weifengdq/BLDC_DRV11873/Picture & Image/J-link.png

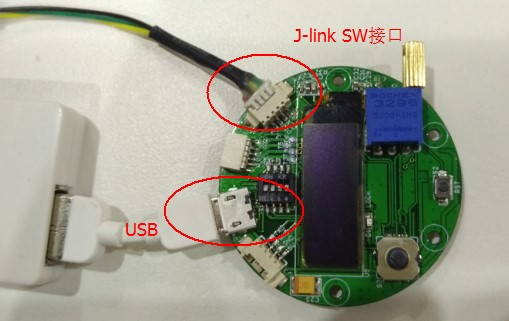
Picture & Image/J-link.png
