weifengdq/BLDC_DRV11873/Picture & Image/B0.png

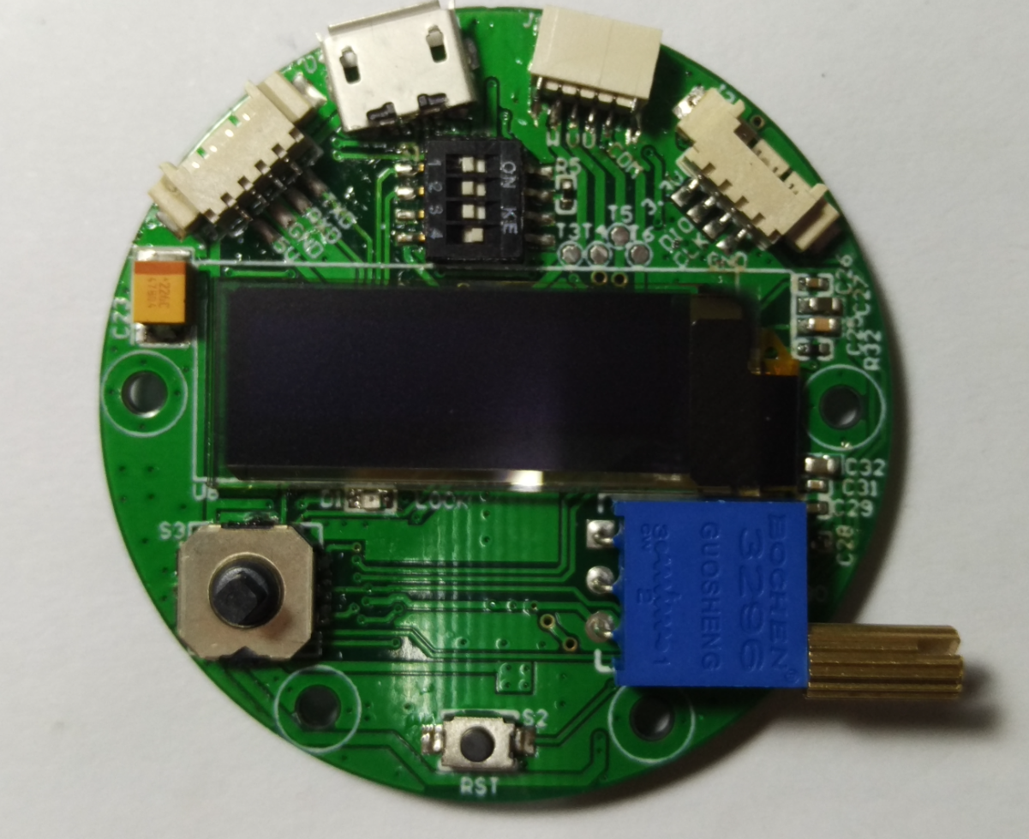
Picture & Image/B0.png
