weifengdq/BLDC_DRV11873/README.md

# BLDC_DRV11873
A BLDC Control Project With DRV11873 Driver, STM32F030F4P6 MCU, OLED, Speed and Current Detection etc.
