weifengdq/BLDC_DRV11873/Picture & Image/ADC0.png

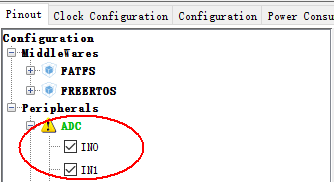
Picture & Image/ADC0.png
