weifengdq/BLDC_DRV11873/Picture & Image/ADC1.png

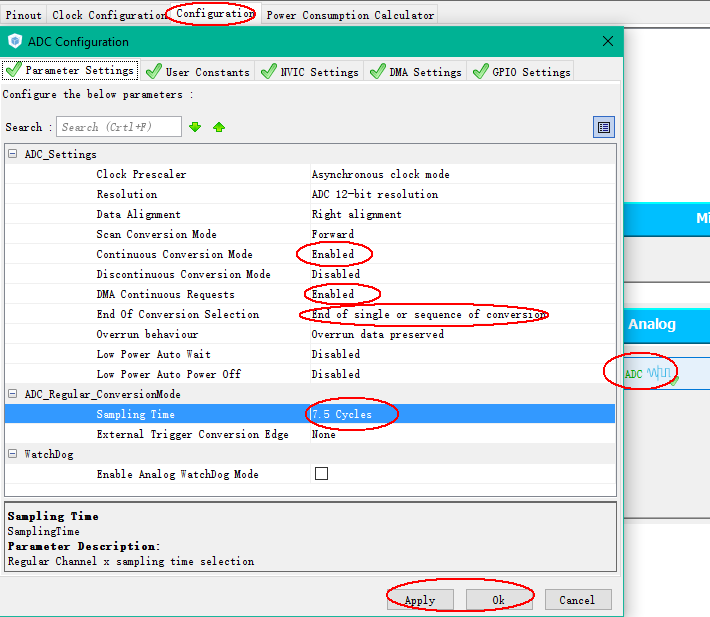
Picture & Image/ADC1.png
