weifengdq/BLDC_DRV11873/Picture & Image/ADC2.png

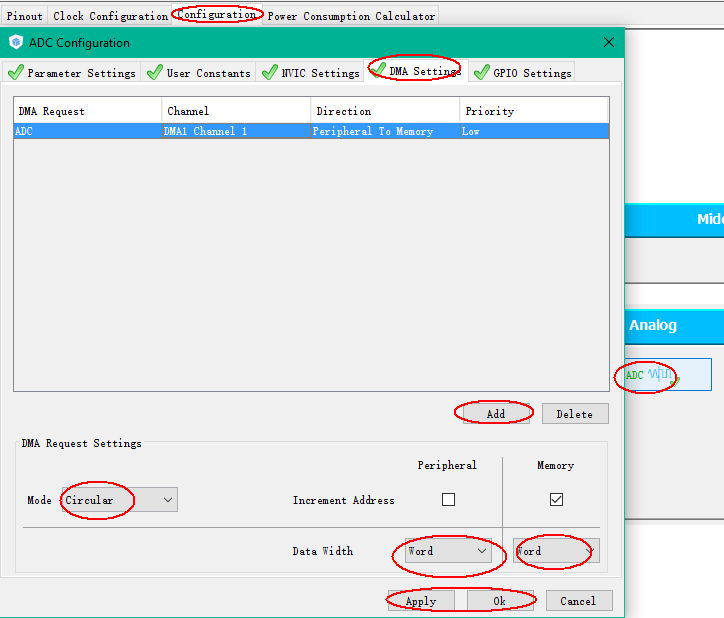
Picture & Image/ADC2.png
