weifengdq/BLDC_DRV11873/Picture & Image/B1.png

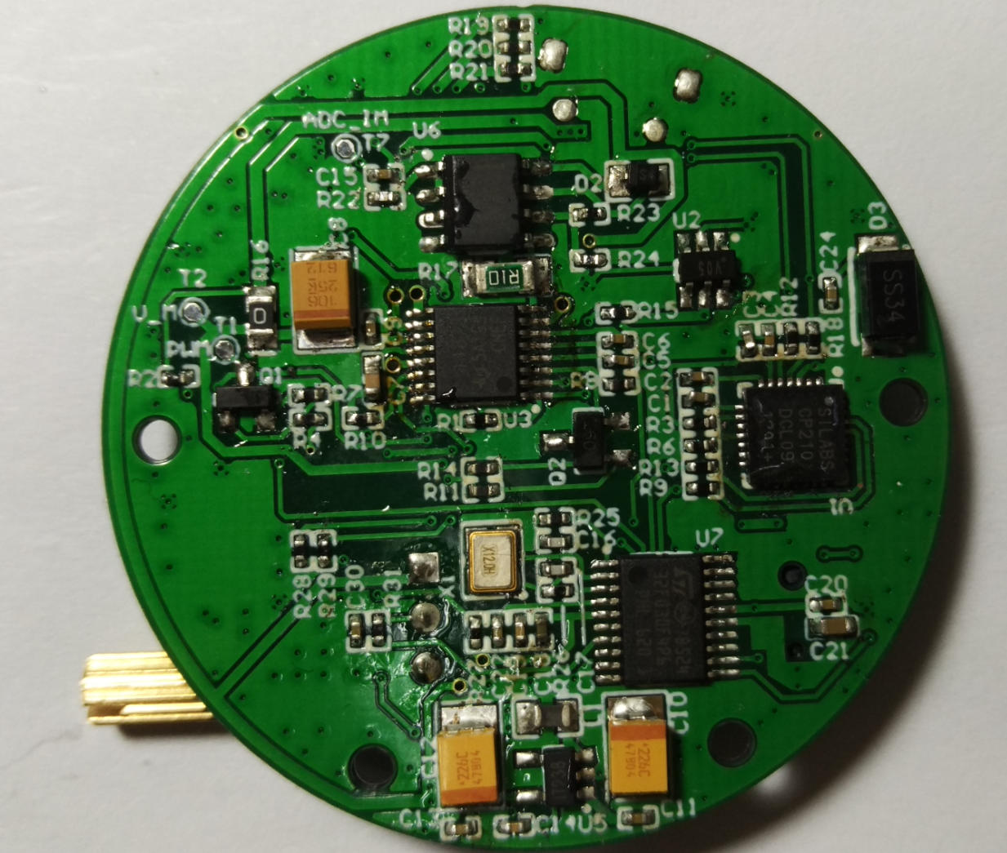
Picture & Image/B1.png
