weifengdq/BLDC_DRV11873/Picture & Image/B2.png

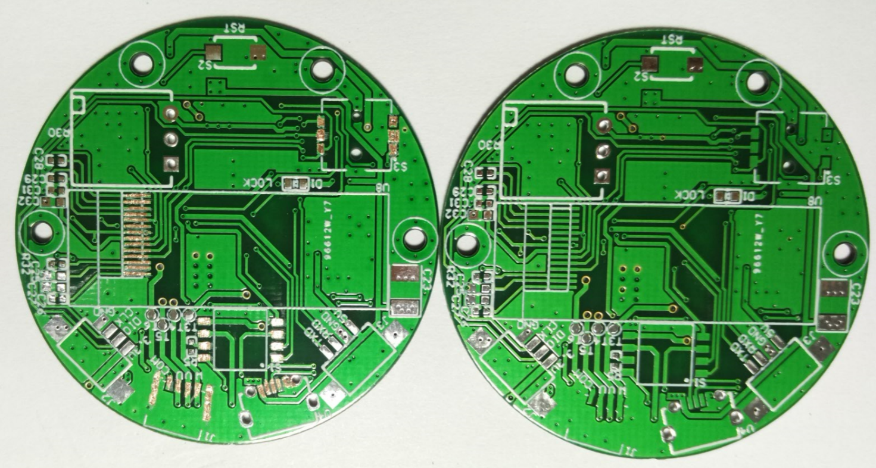
Picture & Image/B2.png
