weifengdq/BLDC_DRV11873/Picture & Image/B3.png

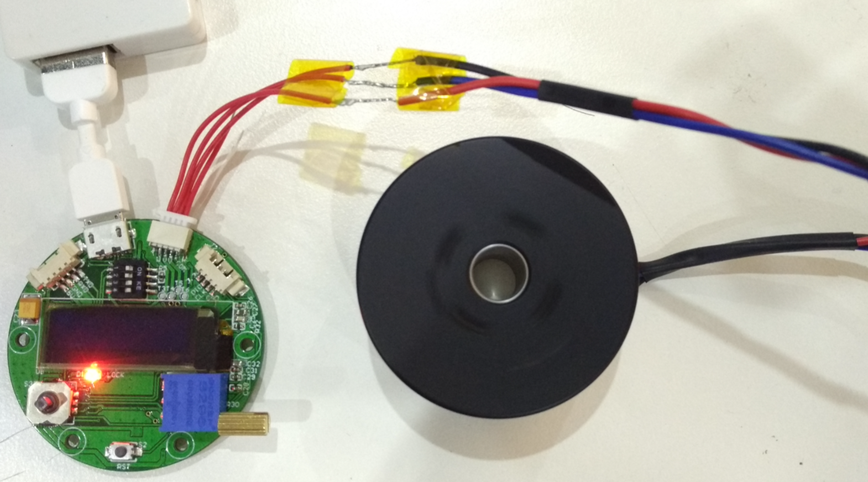
Picture & Image/B3.png
