weifengdq/BLDC_DRV11873/Picture & Image/Clock Configuration.png

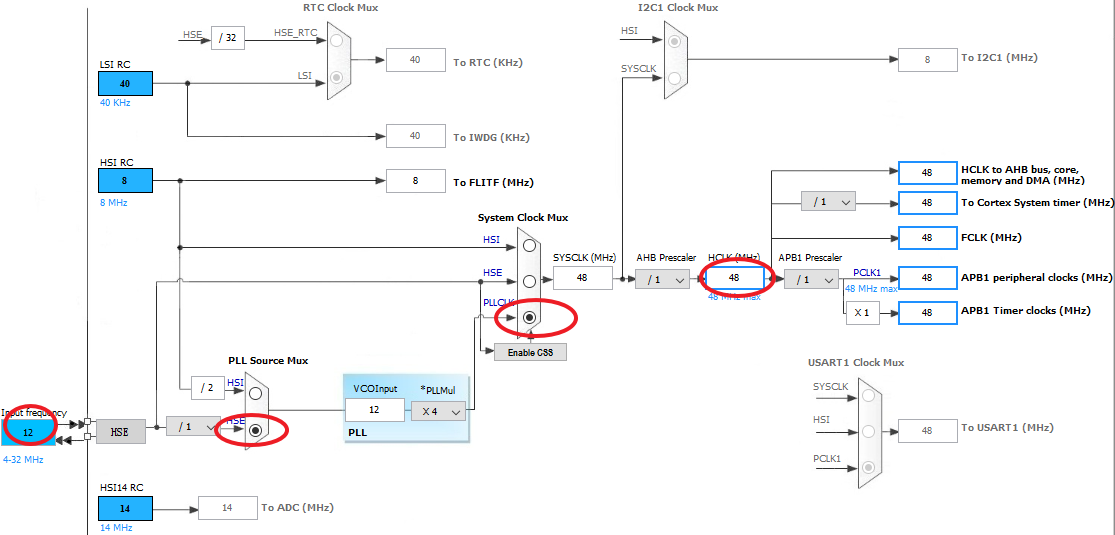
Picture & Image/Clock Configuration.png
