weifengdq/BLDC_DRV11873/Picture & Image/Code Generator.png

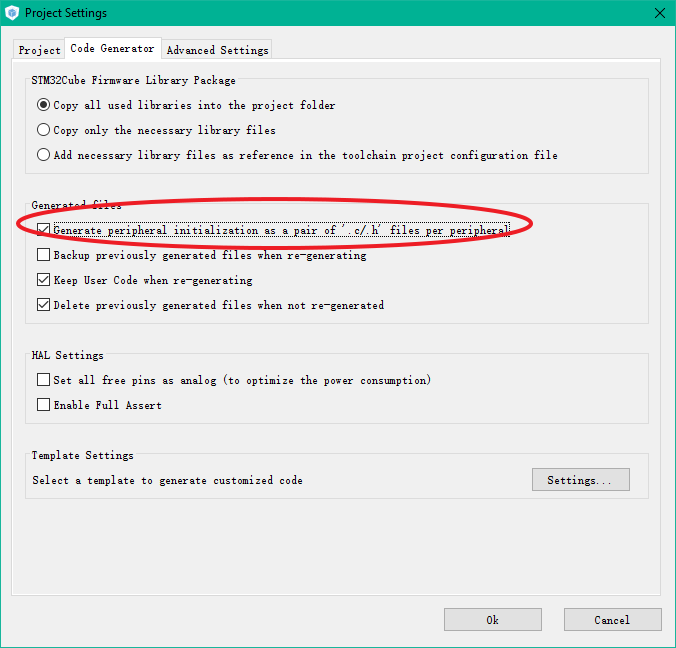
Picture & Image/Code Generator.png
