weifengdq/BLDC_DRV11873/Picture & Image/display.png

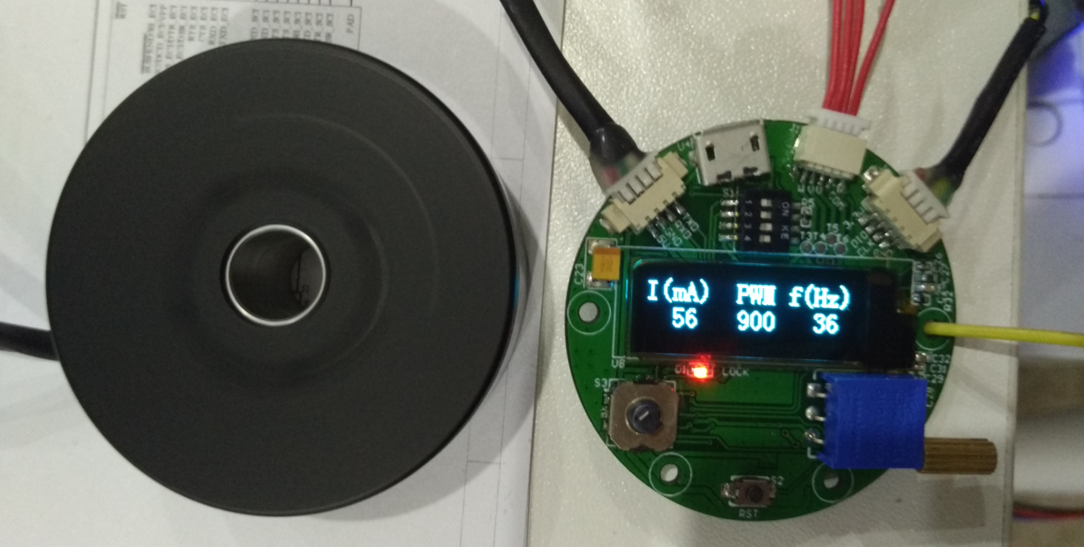
Picture & Image/display.png
