weifengdq/BLDC_DRV11873/Picture & Image/DRV11873官方评估板原理图.png

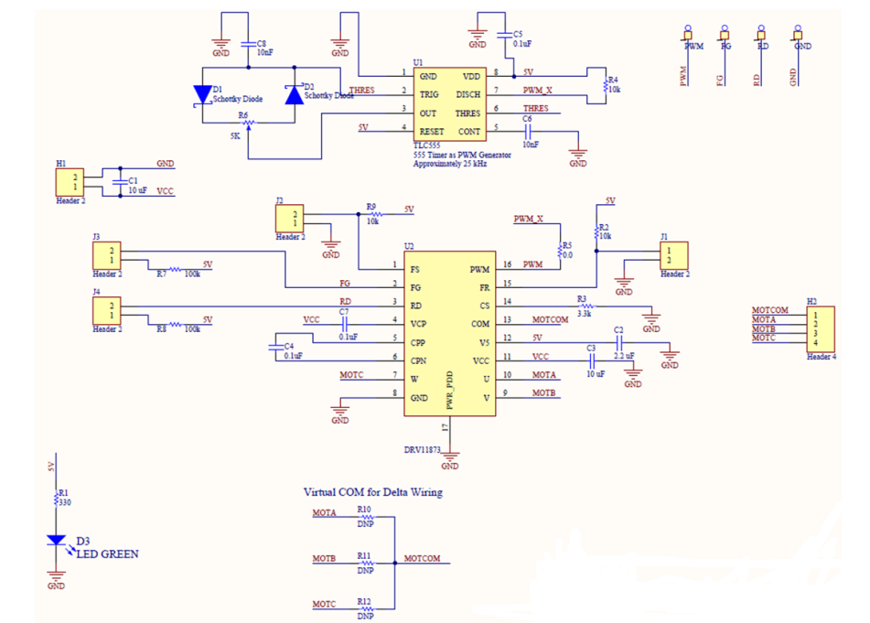
Picture & Image/DRV11873官方评估板原理图.png
