weifengdq/BLDC_DRV11873/Picture & Image/Flash.png

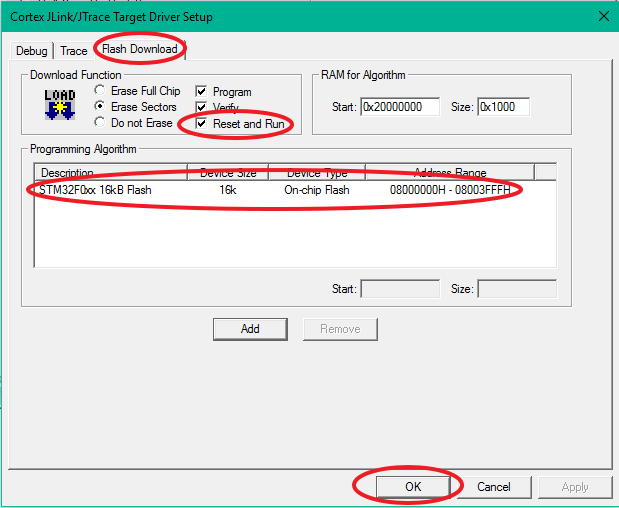
Picture & Image/Flash.png
