weifengdq/BLDC_DRV11873/Picture & Image/IIC.png

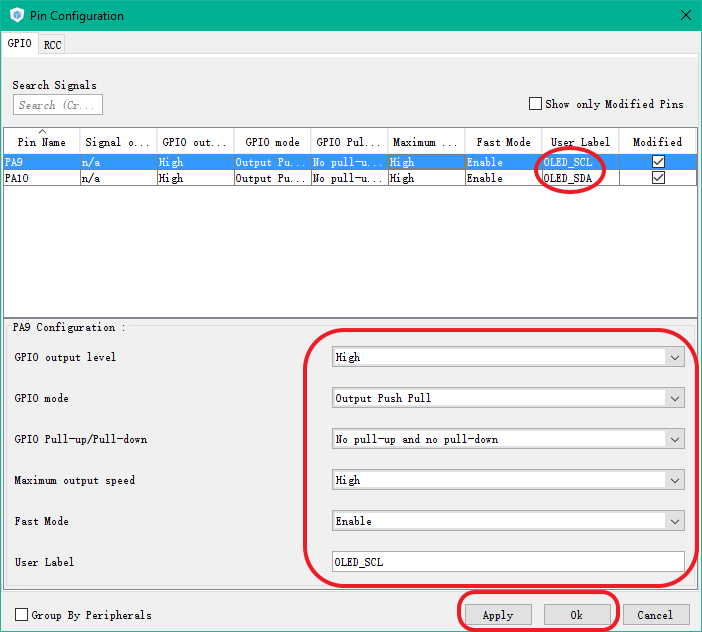
Picture & Image/IIC.png
