weifengdq/BLDC_DRV11873/Picture & Image/Project.png

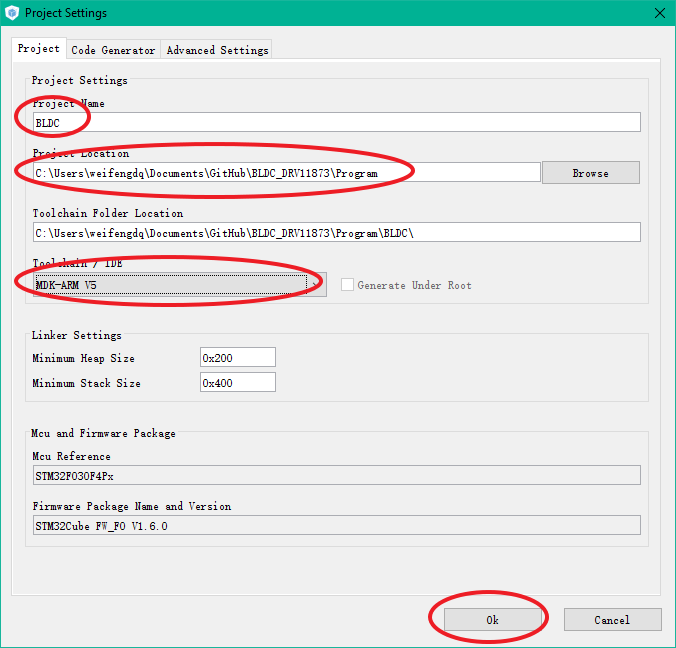
Picture & Image/Project.png
