weifengdq/BLDC_DRV11873/Picture & Image/PWM400.png

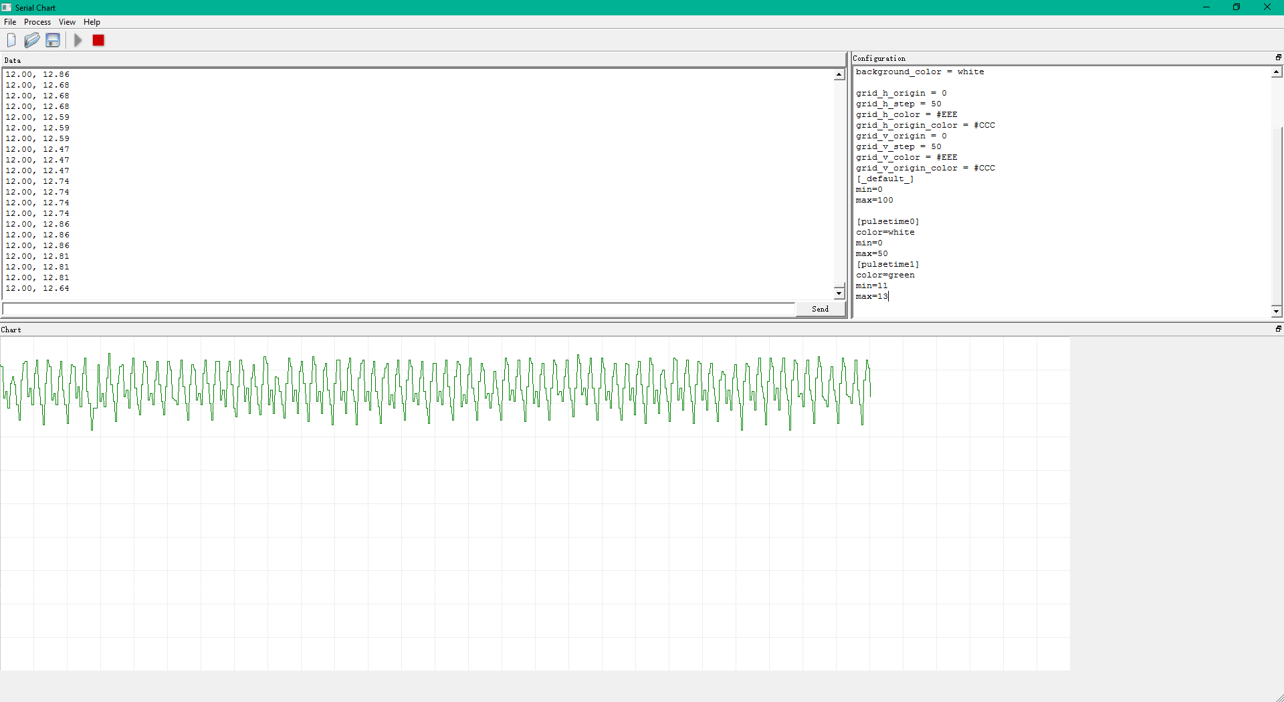
Picture & Image/PWM400.png
