weifengdq/BLDC_DRV11873/Picture & Image/PWM500.png

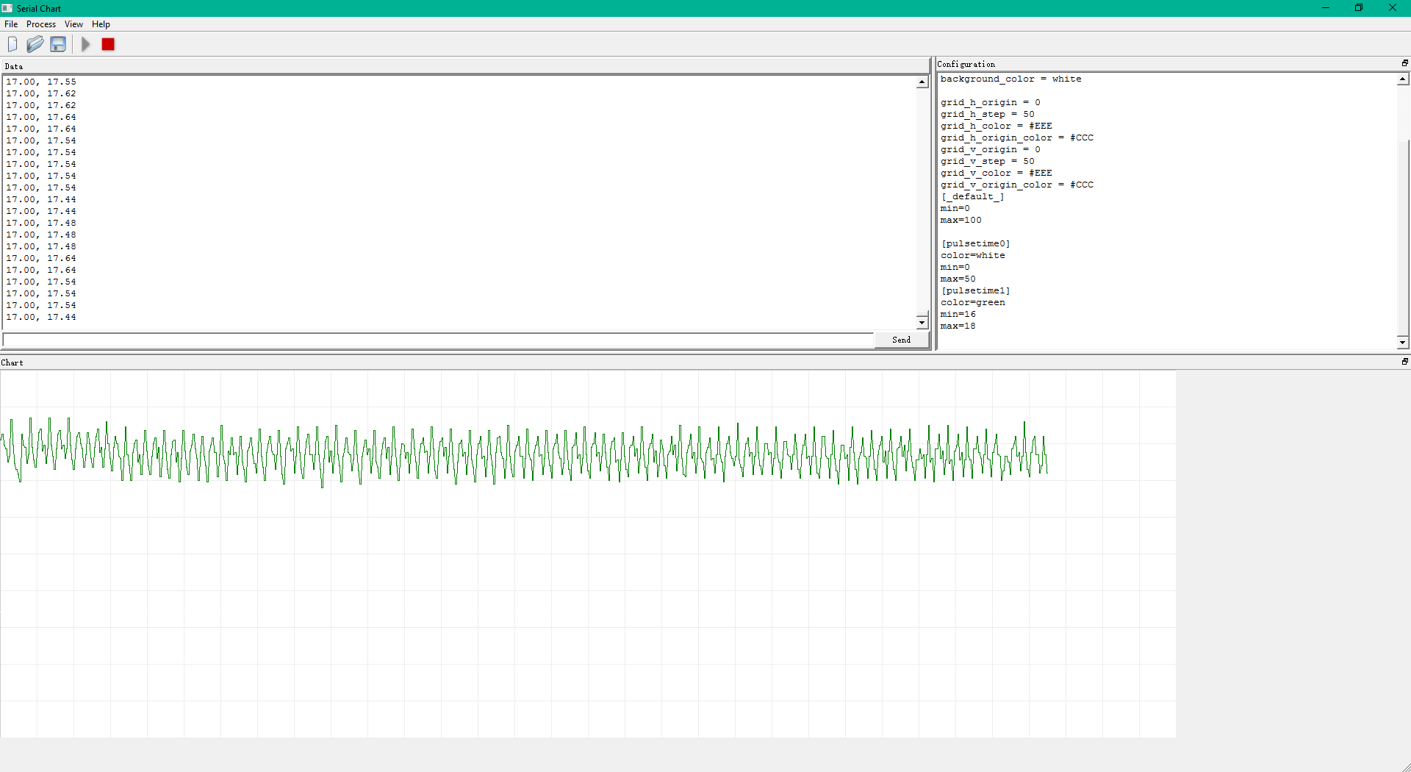
Picture & Image/PWM500.png
