weifengdq/BLDC_DRV11873/Picture & Image/PWM600.png

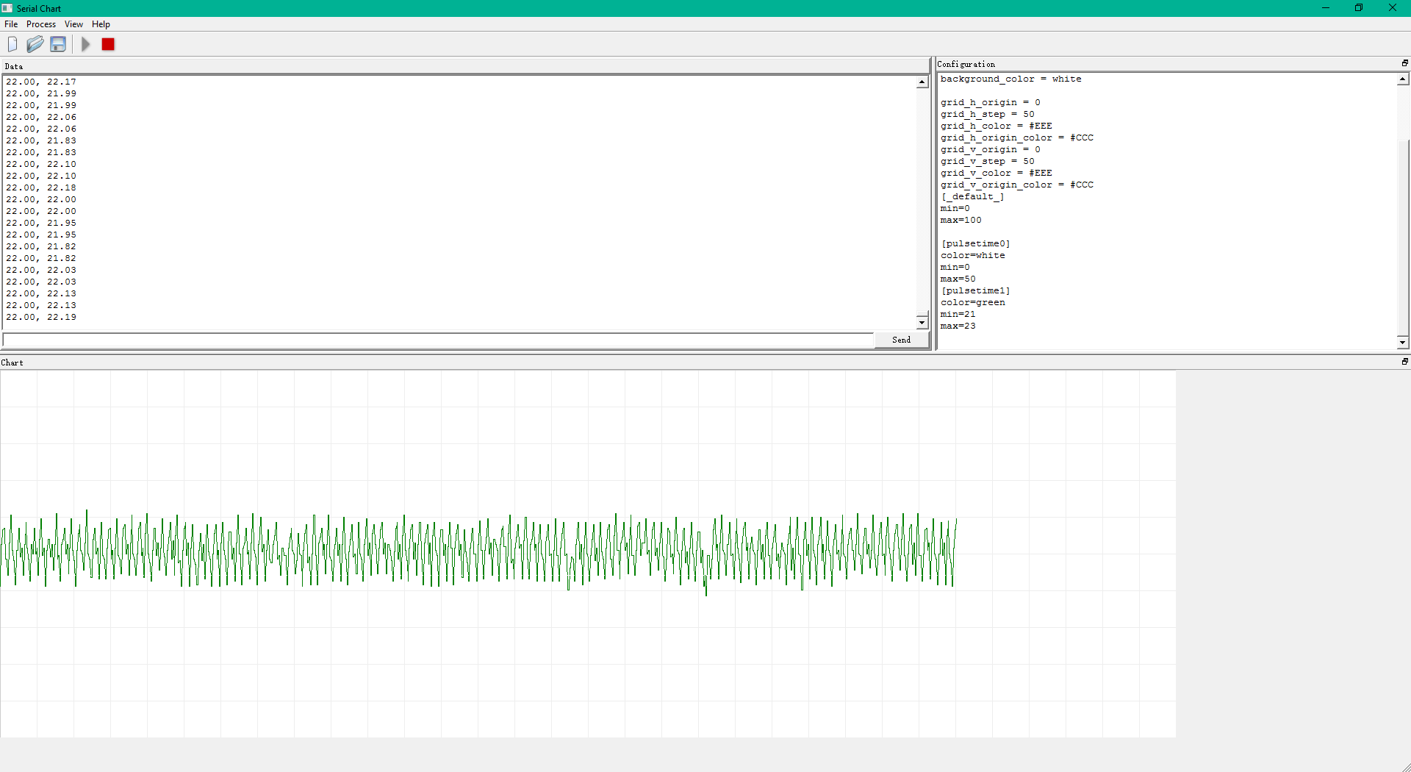
Picture & Image/PWM600.png
