weifengdq/BLDC_DRV11873/Picture & Image/PWM800.png

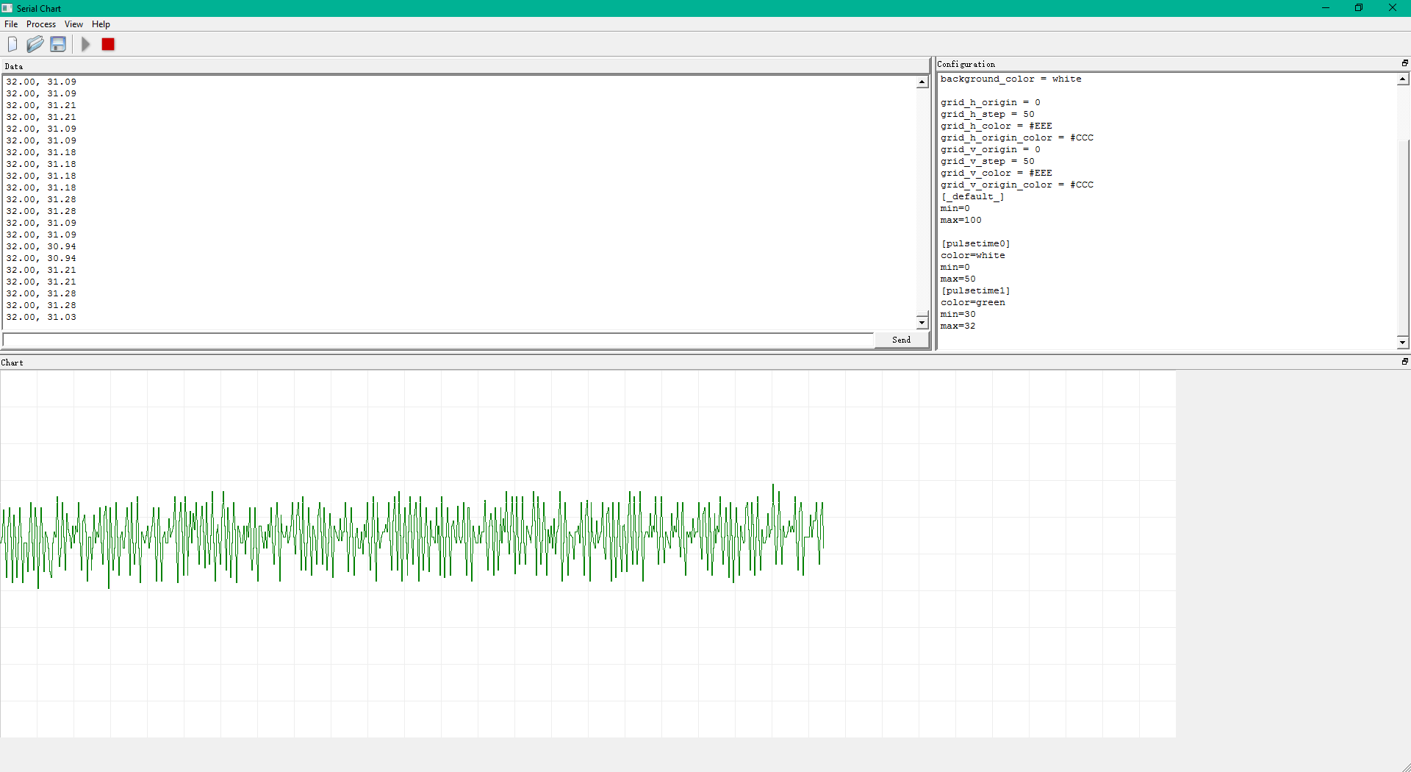
Picture & Image/PWM800.png
