weifengdq/BLDC_DRV11873/Picture & Image/PWM900.png

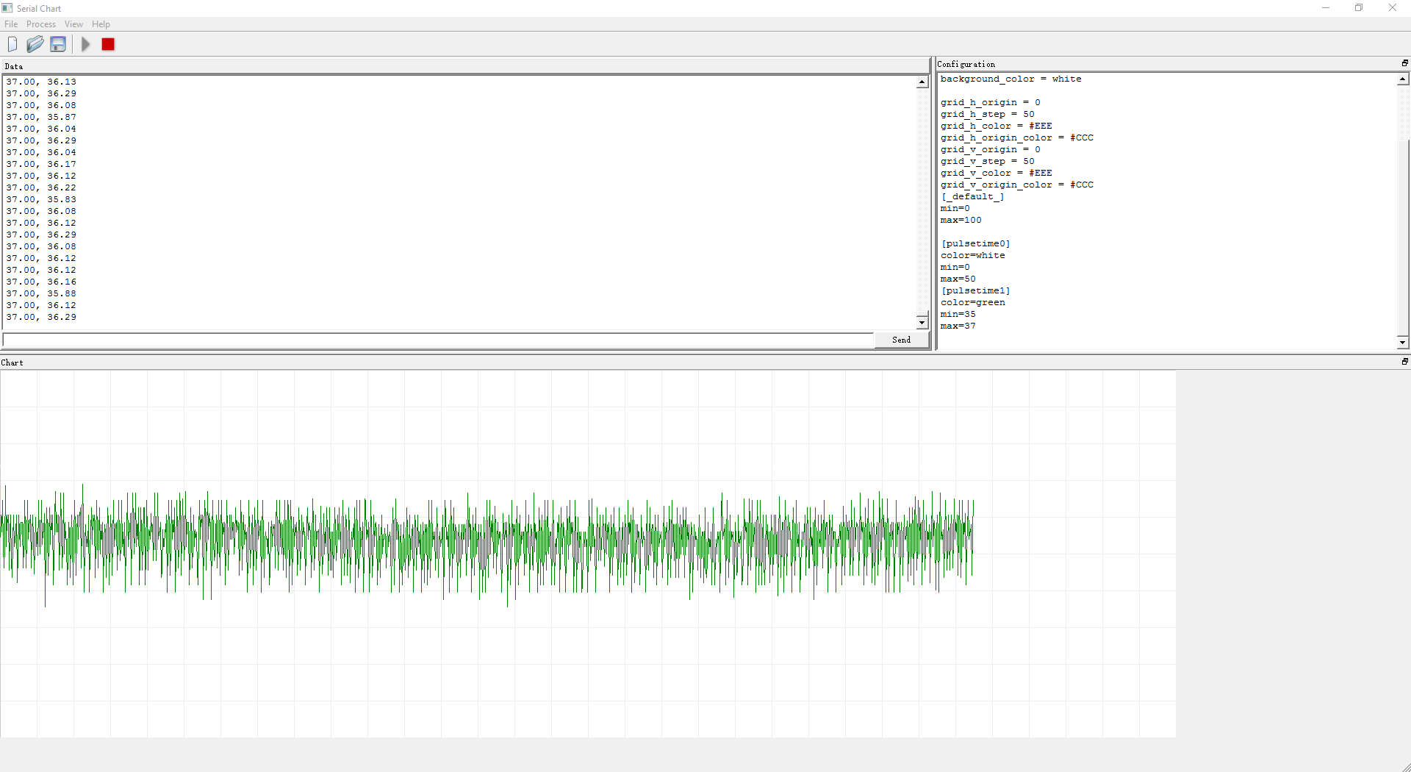
Picture & Image/PWM900.png
