weifengdq/BLDC_DRV11873/Picture & Image/SerialChartSpeed.png

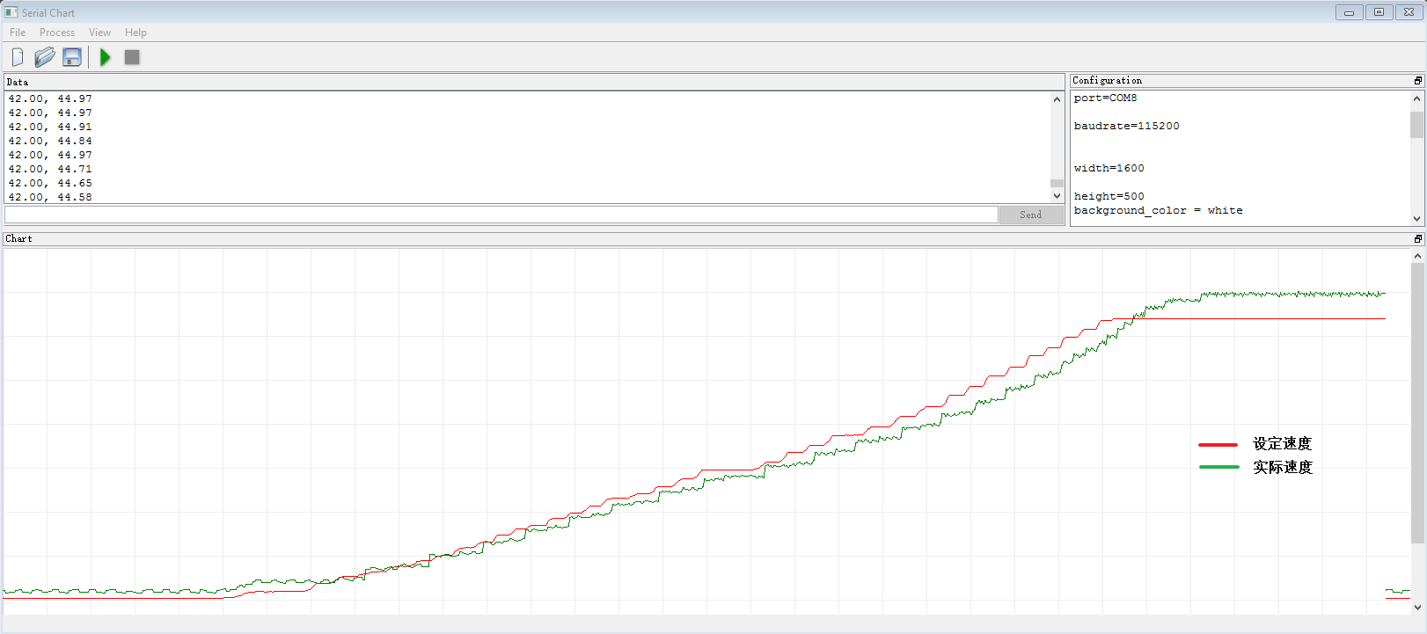
Picture & Image/SerialChartSpeed.png
