weifengdq/BLDC_DRV11873/Picture & Image/XCOM.png

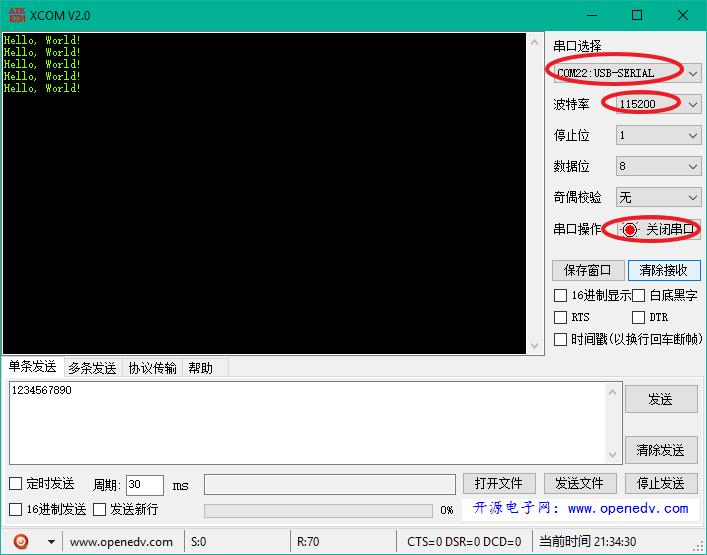
Picture & Image/XCOM.png
