weifengdq/BLDC_DRV11873/Reference/MainChipBOM.xlsx

芯片 | 说明 | 封装 | 参考价格(RMB 元pcs) | 数量 | 总价 | 图片 | 参考链接
STM32F030F4P6 | MCU， 16K Flash， 4K RAM， 4x16bit Timers, 1x12bit ADC, 1xSPI, 1xIIC, 1xUSART, 48MHz | TSSOP20 | 2.2 | 10 | 22 |  | https://detail.tmall.com/item.htm?spm=a230r.1.14.23.oyMC4W&id=40491644138&ns=1&abbucket=19
DRV11873 | 12-V, 3-Phase, Sensorless BLDC Motor Driver | HTSSOP16 | 5.5 | 10 | 55 |  | https://item.taobao.com/item.htm?spm=a230r.1.14.25.sbgPfr&id=537595380751&ns=1&abbucket=19#detail
CP2102 |  | QFN28 | 4.5 | 10 | 45 |  | https://item.taobao.com/item.htm?spm=a230r.1.14.4.8ZaTOn&id=39943267315&ns=1&abbucket=19#detail
SRV05-4.TCT | TVS/ESD 二极管阵列 | SOT23-6 | 0.22 | 10 | 2.2 |  | https://item.taobao.com/item.htm?spm=a230r.1.14.4.1rdaxb&id=16838266169&ns=1&abbucket=8#detail https://item.taobao.com/item.htm?spm=a230r.1.14.11.1rdaxb&id=526073130733&ns=1&abbucket=8#detail
SP6205EM5-3.3 |  | SOT23-5 | 0.6 | 20 | 12 |  | https://item.taobao.com/item.htm?spm=a230r.1.14.4.NFAGwY&id=44904515391&ns=1&abbucket=19#detail
7x7x5mm 五向开关 | 五向开关 |  | 0.9 | 10 | 9 |  | https://item.taobao.com/item.htm?spm=a230r.1.14.25.DZATDp&id=15334863377&ns=1&abbucket=19#detail
A06 圆形按键帽 | 红绿参半 |  | 0.04 | 10 | 0.4 |  | https://item.taobao.com/item.htm?spm=a1z10.3-c.w4002-6949907793.14.JPSXz1&id=521926148997
Micro-USB | 牛角 |  | 0.11 | 100 | 11 |  | https://item.taobao.com/item.htm?id=23230044763
3x4mm 两脚贴片轻触开关 | 按键 |  | 0.1 | 100 | 10 |  | https://item.taobao.com/item.htm?spm=2013.1.w8271180-8118183520.11.AEFQPV&id=12331466133
FPC排座 4P 下接抽拉 |  |  | 0.4 | 10 | 4 |  | https://item.taobao.com/item.htm?spm=a1z10.3-c.w4002-6949907793.10.mTNKr4&id=10827410924
钽电容 10uF/16V |  | 3216 | 0.2 | 100 | 20 |  | https://item.taobao.com/item.htm?spm=a230r.1.14.4.INSOqe&id=522576764043&ns=1&abbucket=19#detail
钽电容 22uF/25V |  | 3528 | 0.2 | 100 | 20 |  | https://item.taobao.com/item.htm?spm=a230r.1.14.4.yab9xT&id=522572781434&ns=1&abbucket=19#detail
3296W-103LF | 10k 带长柄电位器 |  | 0.9 | 10 | 9 |  | https://item.taobao.com/item.htm?spm=a230r.1.14.19.9YMEi3&id=43836320120&ns=1&abbucket=19#detail
1.27mm 4路拨码开关 |  |  | 1.17 | 10 | 11.7 |  | https://item.taobao.com/item.htm?spm=a230r.1.14.30.6hshVp&id=13487360460&ns=1&abbucket=19#detail
1.27mm 2路拨码开关 |  |  | 0.95 | 10 | 9.5 |  | https://item.taobao.com/item.htm?id=17465460080
LM358DR |  | SOP8 | 0.32 | 20 | 6.4 |  | https://item.taobao.com/item.htm?spm=a230r.1.14.4.6lflPM&id=522573942392&ns=1&abbucket=2#detail
1206 0.1R 100毫欧 贴片电流采样取样电阻 1% R100 |  | 1206 | 0.178 | 20 | 3.56 |  | https://item.taobao.com/item.htm?spm=a230r.1.14.10.QMiJjJ&id=531756570566&ns=1&abbucket=2#detail
1206 0.01R 100毫欧 贴片电流采样取样电阻 1% R100 |  | 1206 | 0.178 | 20 | 3.56 |  | https://item.taobao.com/item.htm?spm=2013.1.0.0.n0RNS7&id=531806528125
0.91寸 128*32 OLED |  |  | 11 | 10 | 110 |  | https://item.taobao.com/item.htm?spm=a230r.1.14.43.qNUjYm&id=21190723642&ns=1&abbucket=2#detail
AO3400
