weifengdq/BLDC_DRV11873/Picture & Image/Bug1.png

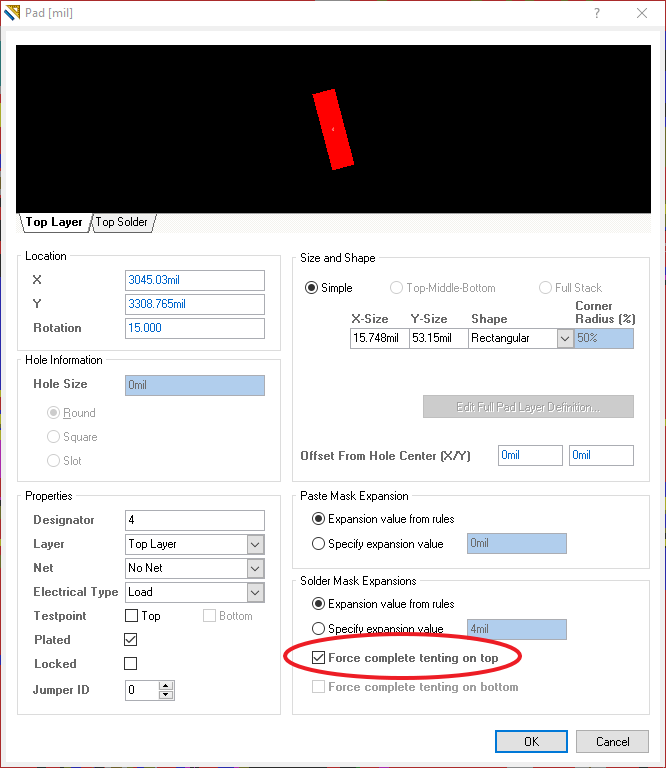
Picture & Image/Bug1.png
