weifengdq/BLDC_DRV11873/Picture & Image/Debug.png

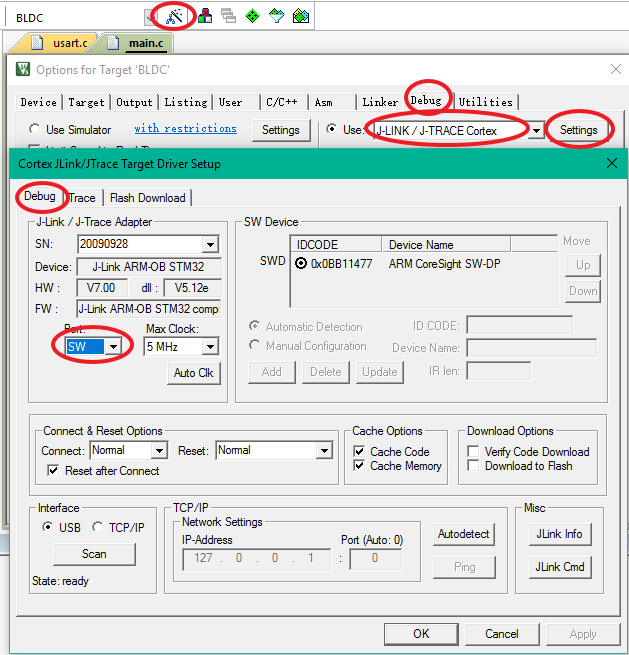
Picture & Image/Debug.png
