weifengdq/BLDC_DRV11873/BLDC_MainBoard_V1.1.pdf

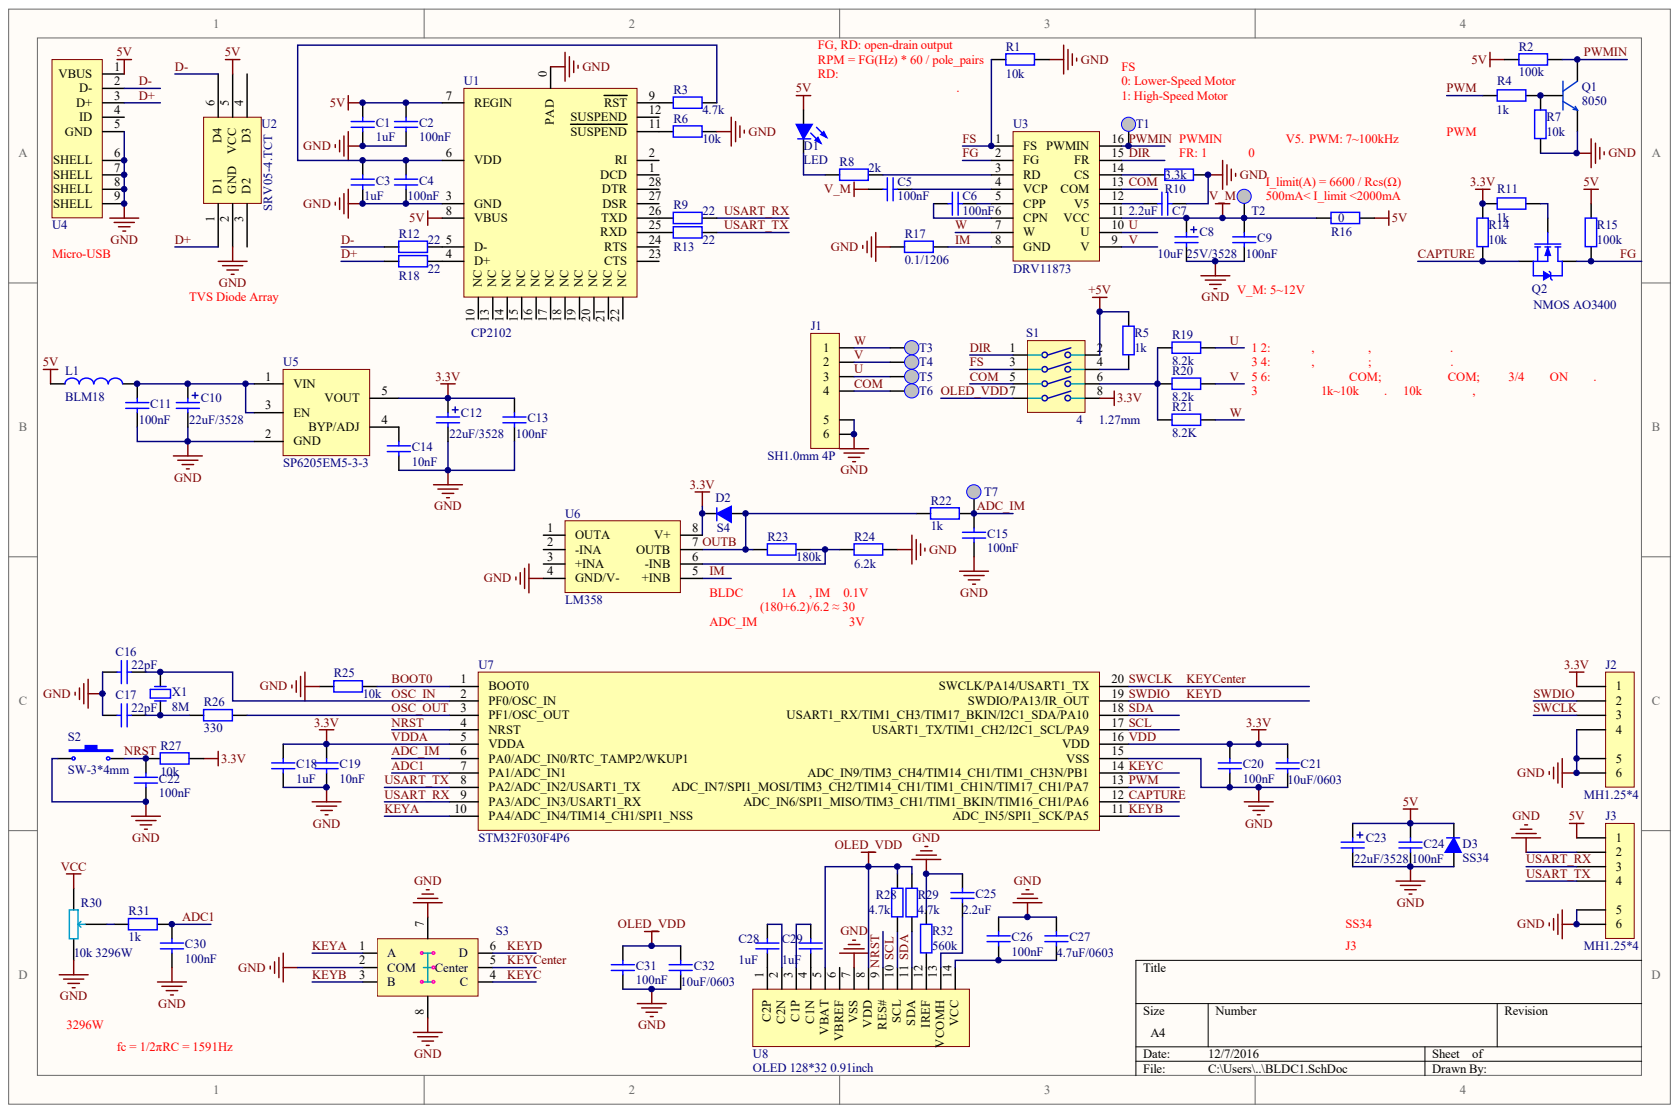
[picture p31: page 1]

FG, RD: open-drain output
RPM = FG(Hz) * 60 / pole_pairs

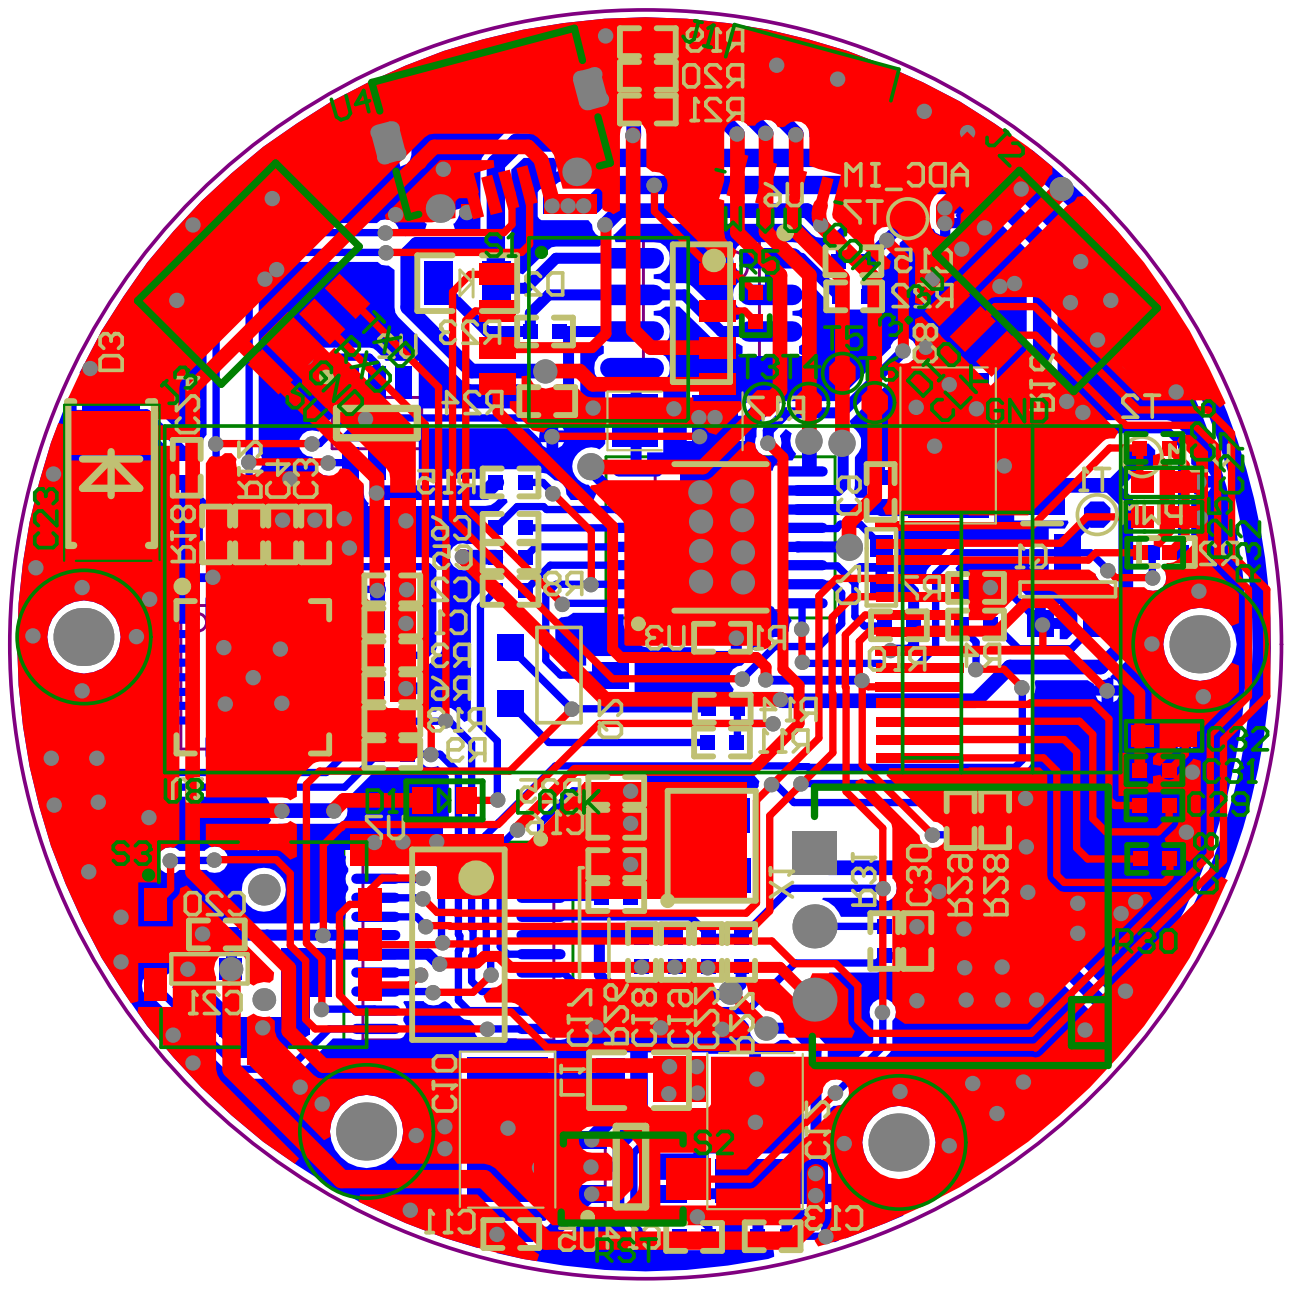
[picture p32: page 2]
