weifengdq/BLDC_DRV11873/(list of files, drawings)

Other design files:
PCB/BLDC1.PcbDoc
PCB/BLDC1.PrjPcb
PCB/BLDC1.SchDoc
