weifengdq/BLDC_DRV11873/Program/BLDC/BLDC.ioc

Mcu.UserName=STM32F030F4Px
PA0.Signal=ADC_IN0
PA1.Signal=ADC_IN1
PA10.GPIO_Label=OLED_SDA
PA10.Signal=GPIO_Output
PA2.Signal=USART1_TX
PA3.Signal=USART1_RX
PA6.Signal=S_TIM3_CH1
PA7.Signal=S_TIM14_CH1
PA9.GPIO_Label=OLED_SCL
PA9.Signal=GPIO_Output
PF0-OSC_IN.Signal=RCC_OSC_IN
PF1-OSC_OUT.Signal=RCC_OSC_OUT
