weifengdq/BLDC_DRV11873/(commit log)

2016-12-07 BLDC First Commit
    [BLDC1.PcbDoc, BLDC1.PrjPcb, BLDC1.SchDoc]
2016-12-07 Add USART PRINTF
2016-12-08 Add PWM, OLED, ADC to Project
2016-12-09 Add CircuitDetection, RPM
2016-12-09 Add BOM
    [MainChipBOM.xlsx]
2016-12-09 Add Picture PWM.
