weifengdq/BLDC_DRV11873/(notices)

Notices in the files:
Program/BLDC/Inc/oled.h:
Copyright(C) ÖÐ¾°Ô°µç×Ó2014/3/16
All rights reserved
